erichVK5/erichVK5-air-quality-monitor/instructions/v1/README.txt

instructions for assembly of the prototype, version 1
