erichVK5/erichVK5-air-quality-monitor/instructions/v1/Step06.JPG

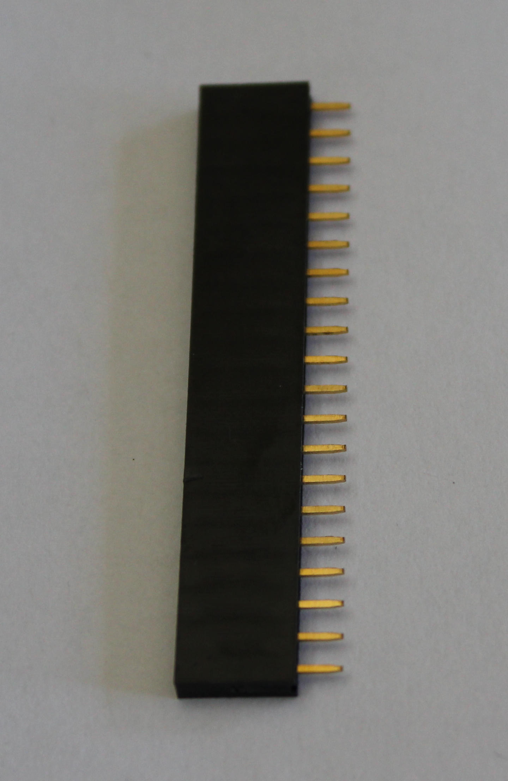
instructions/v1/Step06.JPG
