erichVK5/erichVK5-air-quality-monitor/(commit log)

2021-10-31 Zipped v1 PCB gerbers added to repo
2021-10-31 pcb-rnd PCB layout added to repo
2021-10-31 Add picture of assembled unit
2021-10-31 Add pictue of PCB
2021-10-31 Add PCB image to README
2021-11-02 Assembly photos uploaded
2022-02-15 Added schematic of shield with TM1637 display
2022-02-15 Update readme with shield + TM1637 schematic
2022-02-15 data analysis and assembled unit pictures
2022-02-15 Add hi res assembled stackup picture
2022-10-23 Update LLS-Air-Quality-Monitor-v1.ino
    Add DS1307 RTC option for v2 PCB in code
2022-10-23 Update README to mention v2 PCB option
