erichVK5/erichVK5-air-quality-monitor/(notices)

Notices in the files:
software/LLS-Air-Quality-Monitor-v1/LLS-Air-Quality-Monitor-v1.ino:
This program is free software: you can redistribute it and/or modify
it under the terms of the GNU General Public License as published by
the Free Software Foundation, either version 2 of the License, or
(at your option) any later version.
